BornaBiro/Xmas-Ornament-2025/CrystalBall/PCB/CAD/xmasCrystalBall.kicad_pcb

## KiCad design CrystalBall/PCB/CAD/xmasCrystalBall.kicad_pcb (2025-12-29)

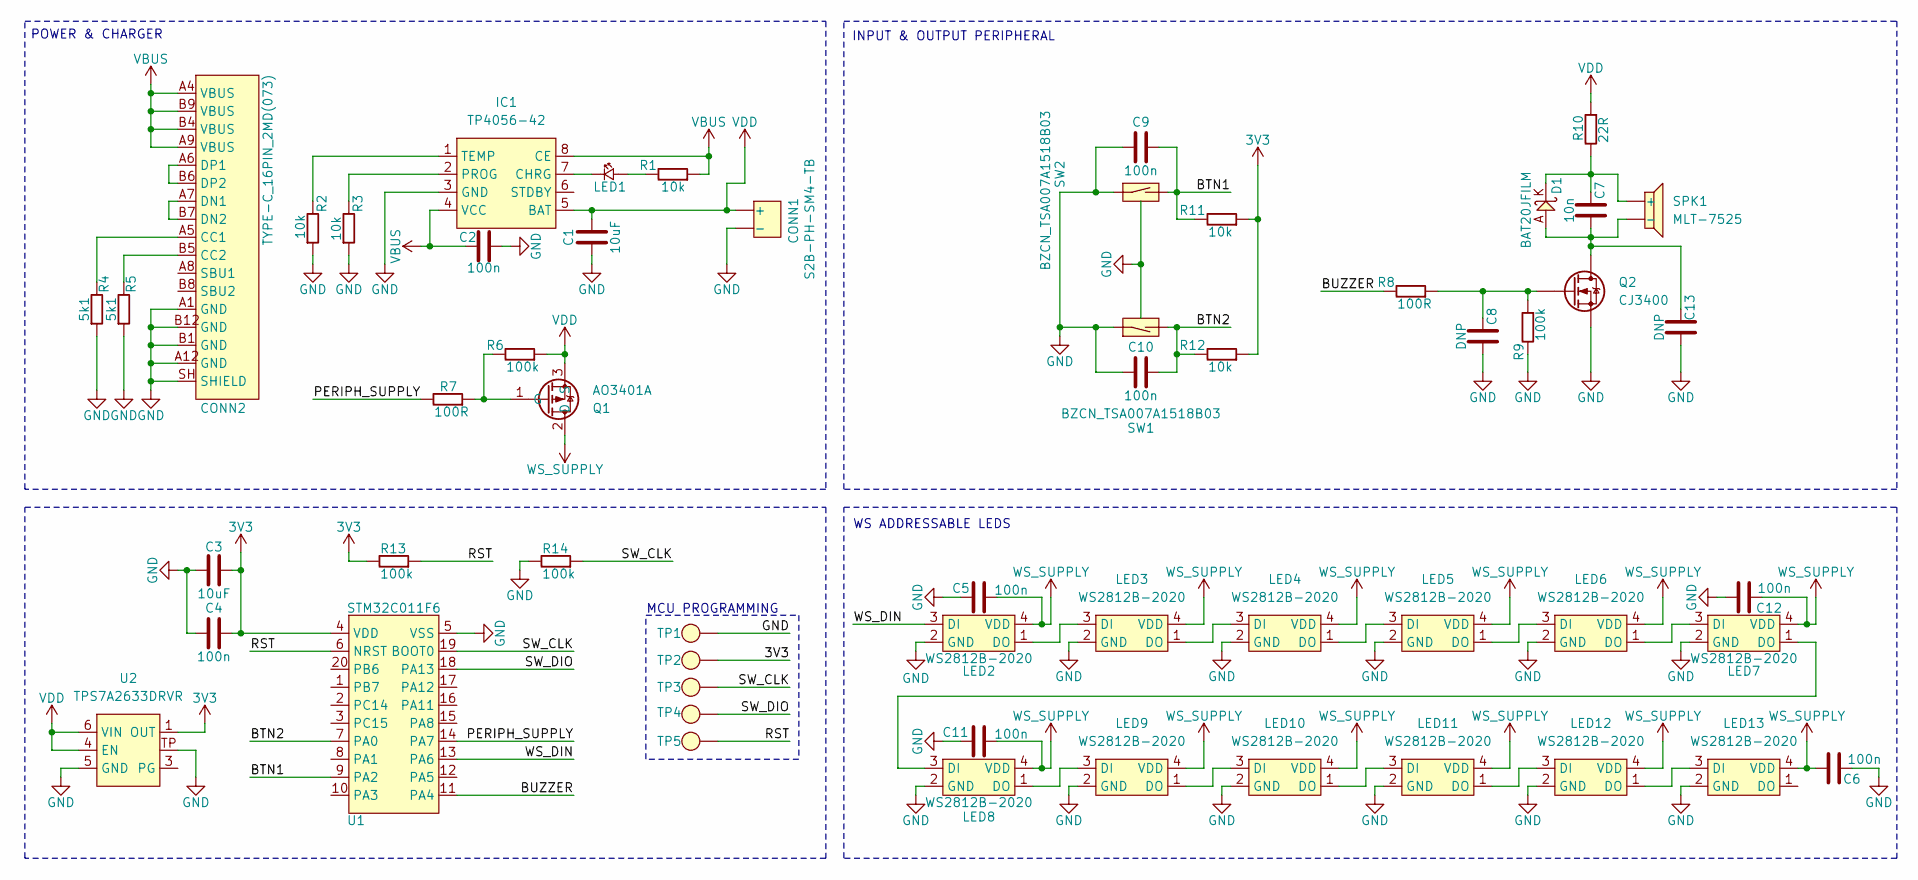
[picture p1: schematic xmasCrystalBall.kicad_sch]

Parts:
C1, C3: 10uF; C1206
C2, C4, C5, C6, C9, C10, C11, C12: 100n; C0603
C7: 10n; C0603
C8, C13: DNP; C0603
CONN1: S2B-PH-SM4-TB; JST_S2B-PH-SM4-TB
CONN2: TYPE-C_16PIN_2MD(073)
D1: BAT20JFILM; SOD323
IC1: TP4056-42; EMSOP
LED1: LED_0603
LED2, LED3, LED4, LED5, LED6, LED7, LED8, LED9, LED10, LED11, LED12, LED13: WS2812B-2020
Q1: AO3401A; SOT-23-3L
Q2: CJ3400; SOT-23-3L
R1, R2, R3, R11, R12: 10k; R0603
R4, R5: 5k1; R0603
R6, R9, R13, R14: 100k; R0603
R7, R8: 100R; R0603
R10: 22R; R0603
SPK1: MLT-7525; MTL-7525
SW1, SW2: BZCN_TSA007A1518B03; TSA007A1518B03
TP1, TP2, TP3, TP4, TP5: TP-1_5mm
U1: STM32C011F6; TSSOP20
U2: TPS7A2633DRVR; WSON-6

Connections:
3V3: C3.2, C4.2, R11.1, R12.1, R13.2, TP2.1 (TP), U1.4 (VDD), U2.1 (OUT)
/BTN1: C9.2, R11.2, SW2.2 (SW2), U1.9 (PA2)
/BTN2: C10.2, R12.2, SW1.2 (SW2), U1.7 (PA0)
/BUZZER: R8.2, U1.11 (PA4)
/PERIPH_SUPPLY: R7.2, U1.14 (PA7)
/RST: R13.1, TP5.1 (TP), U1.6 (NRST)
/SW_CLK: R14.1, TP3.1 (TP), U1.19 (BOOT0)
/SW_DIO: TP4.1 (TP), U1.18 (PA13)
/WS_DIN: LED2.3 (DI), U1.13 (PA6)
GND: C1.1, C2.1, C3.1, C4.1, C5.2, C6.2, C8.1, C9.1, C10.1, C11.2, C12.1, C13.1, CONN1.-, CONN2.A1 (GND), CONN2.A12 (GND), CONN2.B1 (GND), CONN2.B12 (GND), CONN2.SH (SHIELD), IC1.3 (GND), LED2.2 (GND), LED3.2 (GND), LED4.2 (GND), LED5.2 (GND), LED6.2 (GND), LED7.2 (GND), LED8.2 (GND), LED9.2 (GND), LED10.2 (GND), LED11.2 (GND), LED12.2 (GND), LED13.2 (GND), Q2.3 (S), R2.1, R3.1, R4.1, R5.1, R9.2, R14.2, SW1.1 (SW1), SW1.PAD, SW2.1 (SW1), SW2.PAD, TP1.1 (TP), U1.5 (VSS), U2.5 (GND), U2.TP
unnamed: C7.2, D1.K, R10.2, SPK1.+
unnamed: CONN2.A5 (CC1), R4.2
unnamed: CONN2.B5 (CC2), R5.2
unnamed: CONN2.A7 (DN1), CONN2.B7 (DN2)
unnamed: CONN2.A6 (DP1), CONN2.B6 (DP2)
unnamed: IC1.7 (CHRG), LED1.2 (K)
unnamed: IC1.2 (PROG), R3.2
unnamed: IC1.1 (TEMP), R2.2
unnamed: LED1.1 (A), R1.2
unnamed: LED2.1 (DO), LED3.3 (DI)
unnamed: LED3.1 (DO), LED4.3 (DI)
unnamed: LED4.1 (DO), LED5.3 (DI)
unnamed: LED5.1 (DO), LED6.3 (DI)
unnamed: LED6.1 (DO), LED7.3 (DI)
unnamed: LED7.1 (DO), LED8.3 (DI)
unnamed: LED8.1 (DO), LED9.3 (DI)
unnamed: LED9.1 (DO), LED10.3 (DI)
unnamed: LED10.1 (DO), LED11.3 (DI)
unnamed: LED11.1 (DO), LED12.3 (DI)
unnamed: LED12.1 (DO), LED13.3 (DI)
unnamed: Q1.1 (G), R6.2, R7.1
unnamed: C7.1, C13.2, D1.A, Q2.2 (D), SPK1.-
unnamed: C8.2, Q2.1 (G), R8.1, R9.1
VBUS: C2.2, CONN2.A4 (VBUS), CONN2.A9 (VBUS), CONN2.B4 (VBUS), CONN2.B9 (VBUS), IC1.4 (VCC), IC1.8 (CE), R1.1
VDD: C1.2, CONN1.+, IC1.5 (BAT), Q1.3 (S), R6.1, R10.1, U2.4 (EN), U2.6 (VIN)
WS_SUPPLY: C5.1, C6.1, C11.1, C12.2, LED2.4 (VDD), LED3.4 (VDD), LED4.4 (VDD), LED5.4 (VDD), LED6.4 (VDD), LED7.4 (VDD), LED8.4 (VDD), LED9.4 (VDD), LED10.4 (VDD), LED11.4 (VDD), LED12.4 (VDD), LED13.4 (VDD), Q1.2 (D)

Notes on the sheet:
INPUT & OUTPUT PERIPHERAL
POWER & CHARGER
WS ADDRESSABLE LEDS
MCU PROGRAMMING

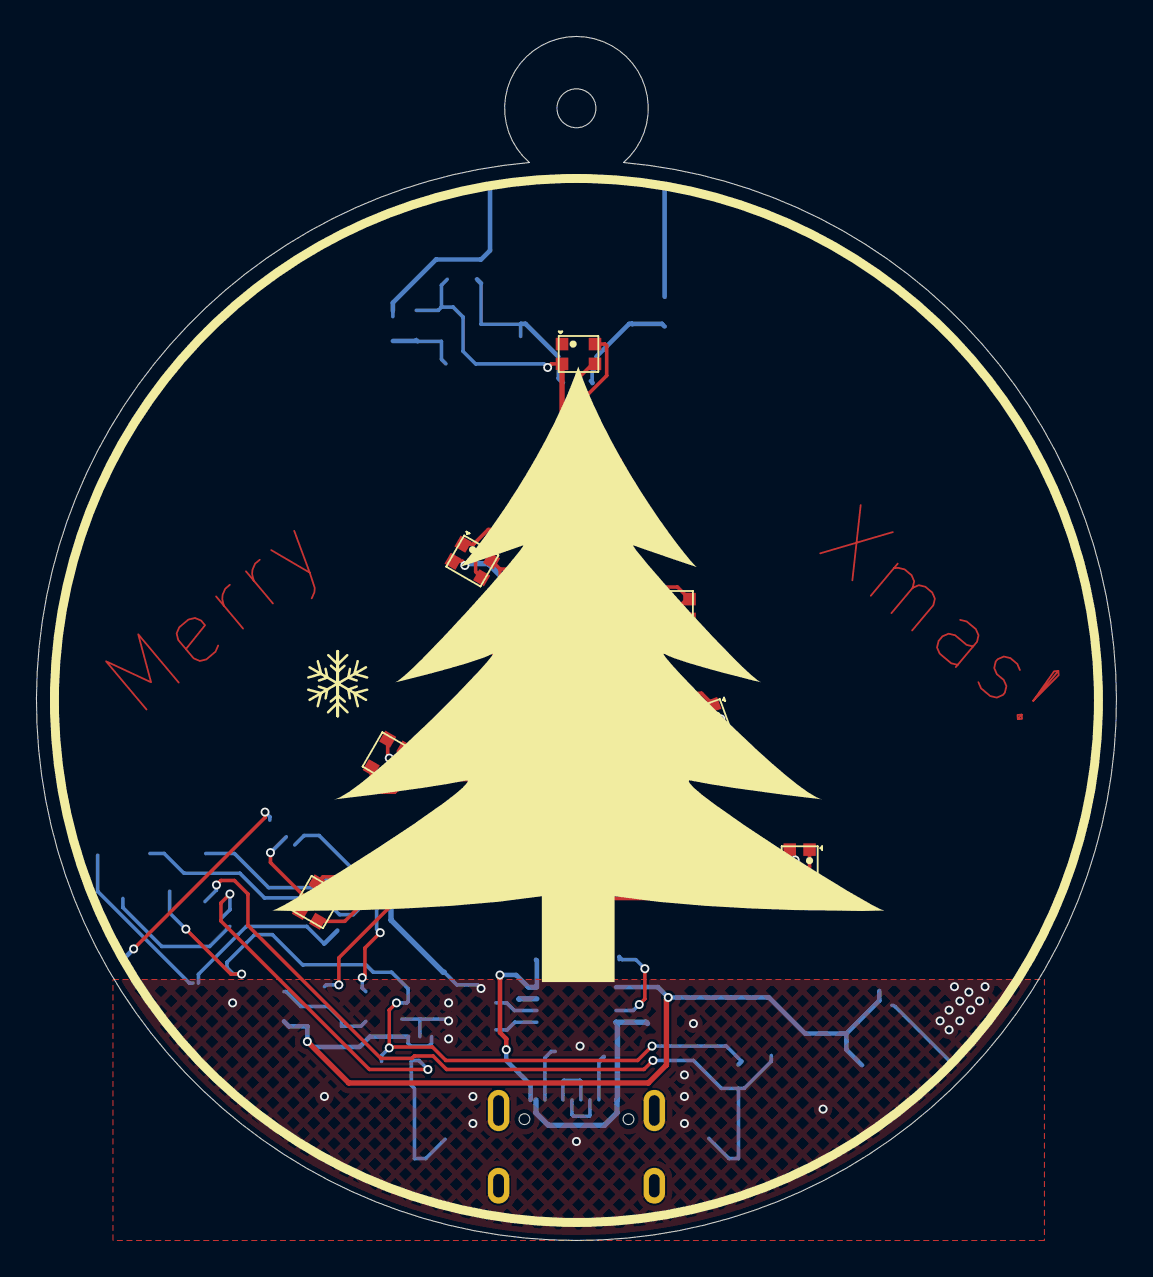
[picture p2: board xmasCrystalBall.kicad_pcb from above]

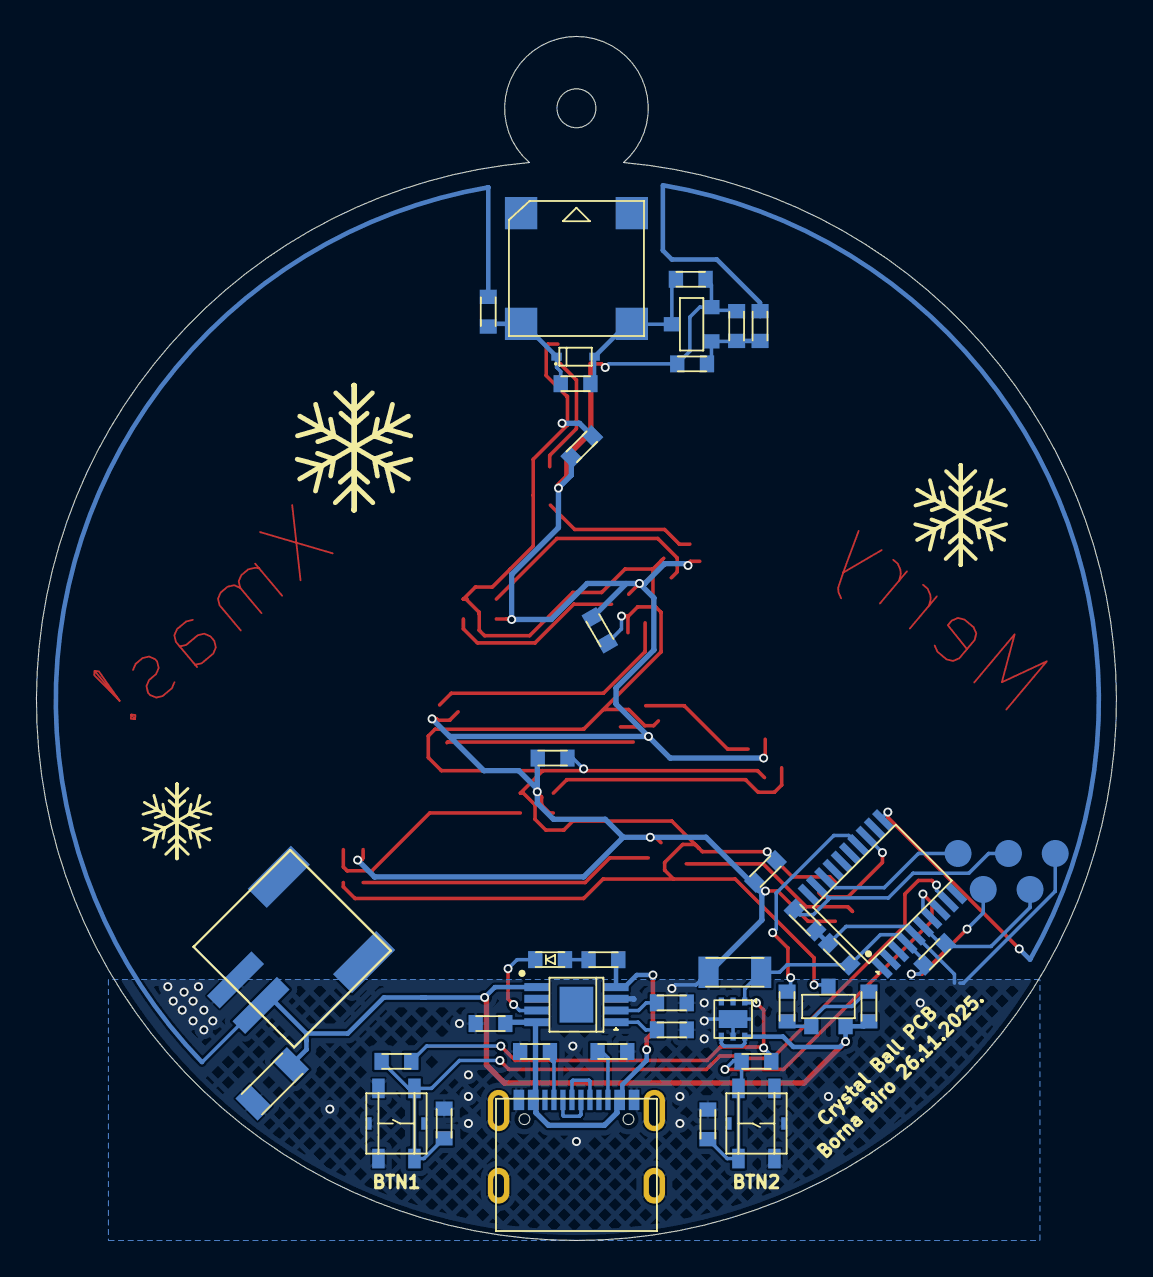
[picture p3: board xmasCrystalBall.kicad_pcb from below]

Board: 2 copper layers, 60.0 x 66.9 mm, 56 parts (44 on the bottom side), 36 nets.
