BornaBiro/Xmas-Ornament-2025/CrystalBall/Firmware/xmasOrnament2025/Core/Src/main.cpp

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
/* Includes ------------------------------------------------------------------*/
#include "main.h"

/* USER CODE BEGIN Includes */
#include <stdint.h>
#include <stdbool.h>
#include "WS2812.h"
#include "Buzzer.h"
#include "oneButton.h"
#include "melodioes.h"
#include "melodyController.h"
/* USER CODE END Includes */

/* USER CODE BEGIN PD */
#define DEVICE_AUTO_OFF_TIME_MS     (5ULL * 60ULL * 1000ULL)
/* USER CODE END PD */


TIM_HandleTypeDef htim3;
TIM_HandleTypeDef htim14;
DMA_HandleTypeDef hdma_tim3_ch1;

/* USER CODE BEGIN PV */
typedef struct
{
    uint16_t hue;
    uint8_t sat;
    uint8_t val;
}hsvColorTypedef;

hsvColorTypedef xmasColors[] =
{
        {       // Red color
                .hue = (uint16_t)(0.0 / 360.0 * 65535),
                .sat = (uint8_t)(94.0 / 100.0 * 255.0),
                .val = 13
        },
        {       // Green color
                .hue = (uint16_t)(105.0 / 360.0 * 65535),
                .sat = (uint8_t)(82.0 / 100.0 * 255.0),
                .val = 5
        },
        {       // Yellow color
                .hue = (uint16_t)(35.0 / 360.0 * 65535),
                .sat = (uint8_t)(98.0 / 100.0 * 255.0),
                .val = 15
        },
        {       // Blue color
                .hue = (uint16_t)(202.0 / 360.0 * 65535),
                .sat = (uint8_t)(94.0 / 100.0 * 255.0),
                .val = 4
        },
        {       // Pink color
                .hue = (uint16_t)(359.0 / 360.0 * 65535),
                .sat = (uint8_t)(80.0 / 100.0 * 255.0),
                .val = 13
        },
        {       // White color
                .hue = (uint16_t)(200.0 / 360.0 * 65535),
                .sat = (uint8_t)(20.0 / 100.0 * 255.0),
                .val = 5
        },
        {       // Warm white color
                .hue = (uint16_t)(30.0 / 360.0 * 65535),
                .sat = (uint8_t)(81.0 / 100.0 * 255.0),
                .val = 10
        }
};

uint32_t onTime = 0;
int ledColorShift = 0;
uint8_t _ledMode = 0;
/* USER CODE END PV */

void SystemClock_Config(void);
static void MX_GPIO_Init(void);
static void MX_DMA_Init(void);
static void MX_TIM3_Init(void);
static void MX_TIM14_Init(void);
/* USER CODE BEGIN PFP */
OneButton btn1;
OneButton btn2;

// Create an object for the melody controller.
MelodyController melody;

void deviceShutDown();
/* USER CODE END PFP */

/**
  * @brief  The application entry point.
  * @retval int
  */
int main(void)
{

  /* MCU Configuration--------------------------------------------------------*/

  /* Reset of all peripherals, Initializes the Flash interface and the Systick. */
  HAL_Init();

  /* Configure the system clock */
  SystemClock_Config();

  /* Initialize all configured peripherals */
  MX_GPIO_Init();
  MX_DMA_Init();
  MX_TIM3_Init();
  MX_TIM14_Init();
  /* USER CODE BEGIN 2 */

  // Enable the supply for the buzzer and LEDs.
  HAL_GPIO_WritePin(PERIPH_EN_GPIO_Port, PERIPH_EN_Pin, GPIO_PIN_RESET);
  // Wait a little bit.
  HAL_Delay(100ULL);

  // Initialize the buzzer library.
  buzzer_begin(&htim14);

  // Initialize the WS LED library.
  if (!ws2812_begin(&htim3, &hdma_tim3_ch1, TIM_CHANNEL_1, 12, 2, 9, 6, 3))
  {
      while(1);
  }

  // Init library for the melody contoller.
  melody.begin((uint16_t**)currentMelodyNotes, (uint16_t**)currentMelodyDurations, (uint8_t*)melodyElements, sizeof(melodyElements) / sizeof(melodyElements[0]));
  melody.play();
  /* USER CODE END 2 */

  /* Infinite loop */
  /* USER CODE BEGIN WHILE */
  while (1)
  {
      // Check the button(s).
      btn1.loop();
      btn2.loop();

      int update = melody.update();

      if (btn1.isPressed())
              melody.next();

      if (btn2.isPressed())
      {
          _ledMode = (_ledMode + 1) % 3;
      }

      if (btn2.isLongPressed())
      {
          melody.setMute(!melody.getMute());
      }

      if (btn1.isLongPressed())
      {
          deviceShutDown();
      }

      // Go thought the colors every one second.
      if (update)
      {
          if (update == 2)
              _ledMode = (_ledMode + 1) % 3;

          if (_ledMode == 0)
          {
              uint8_t colors[] = {0, 2};
              // Set the new colors on LEDs.
              for (int i = 0; i < 12; i++)
              {
                  uint8_t _currentColorIndex = colors[(i + ledColorShift / 2) % 2] + (ledColorShift & 1);
                  ws2812_setPixelColor(i, ws2812_hsv(xmasColors[_currentColorIndex].hue, xmasColors[_currentColorIndex].sat, xmasColors[_currentColorIndex].val));
              }
              ledColorShift++;

              // Push the new colors to the LEDs.
              ws2812_show();
          }
          else if (_ledMode == 1)
          {
              // Set the new colors on LEDs.
              for (int i = 0; i < 12; i++)
              {
                  ws2812_setPixelColor(i, ws2812_hsv(xmasColors[(ledColorShift + i) % 5].hue, xmasColors[(ledColorShift + i) % 5].sat, xmasColors[(ledColorShift + i) % 5].val));
              }
              ledColorShift++;

              // Push the new colors to the LEDs.
              ws2812_show();
          }
          else if (_ledMode == 2)
          {
              // Set the new colors on LEDs.
              for (int i = 0; i < 12; i++)
              {
                  ws2812_setPixelColor(i, ws2812_hsv(xmasColors[ledColorShift % 5].hue, xmasColors[ledColorShift % 5].sat, xmasColors[ledColorShift % 5].val));
              }
              ledColorShift++;

              // Push the new colors to the LEDs.
              ws2812_show();
          }
      }

      // If 10 minutes passed, shut down the ornament and prepare everything for the power up on the button.
      if ((uint32_t)(HAL_GetTick() - onTime) > DEVICE_AUTO_OFF_TIME_MS)
      {
          // Update the timer.
          onTime = HAL_GetTick();

          deviceShutDown();
      }
    /* USER CODE END WHILE */

    /* USER CODE BEGIN 3 */
  }
  /* USER CODE END 3 */
}

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
/* USER CODE BEGIN 4 */
void HAL_GPIO_EXTI_Rising_Callback(uint16_t GPIO_Pin)
{
    //risingInt = true;
    if (GPIO_Pin == GPIO_PIN_2) btn1.updateState(HAL_GetTick(), 1);
    if (GPIO_Pin == GPIO_PIN_0) btn2.updateState(HAL_GetTick(), 1);
}

void HAL_GPIO_EXTI_Falling_Callback(uint16_t GPIO_Pin)
{
    if (GPIO_Pin == GPIO_PIN_2) btn1.updateState(HAL_GetTick(), 0);
    if (GPIO_Pin == GPIO_PIN_0) btn2.updateState(HAL_GetTick(), 0);
}

void deviceShutDown()
{
    // Turn off all LEDs.
    for (int i = 0; i < 12; i++)
    {
        ws2812_setPixelColor(i, 0);
    }

    // Push the new colors to the LEDs.
    ws2812_show();

    // Disable the supply to the LEDs and buzzer.
    HAL_GPIO_WritePin(PERIPH_EN_GPIO_Port, PERIPH_EN_Pin, GPIO_PIN_SET);

    // Disable the timers for LEDs and buzzer.
    HAL_TIM_PWM_DeInit(&htim14);
    HAL_TIM_PWM_DeInit(&htim3);

    while(HAL_GPIO_ReadPin(GPIOA, GPIO_PIN_2) == GPIO_PIN_RESET);

    // Set the wake up pins.
    //HAL_PWR_DisableWakeUpPin(PWR_WAKEUP_PIN1);
    HAL_PWR_DisableWakeUpPin(PWR_WAKEUP_PIN4);
    //HAL_PWR_EnableWakeUpPin(PWR_WAKEUP_PIN1_LOW);
    HAL_PWR_EnableWakeUpPin(PWR_WAKEUP_PIN4_LOW);
    __HAL_PWR_CLEAR_FLAG(PWR_FLAG_WUF);

    // Disable the tick
    HAL_SuspendTick();

    // Shut-down whole device.
    HAL_PWREx_EnterSHUTDOWNMode();
}
/* USER CODE END 4 */
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
