BornaBiro/Xmas-Ornament-2025/CrystalBall/Firmware/xmasOrnament2025/xmasOrnament2025.ioc

Mcu.UserName=STM32C011F6Px
PA0.GPIO_Label=USER_BTN2
PA0.Signal=GPXTI0
PA2.GPIO_Label=USER_BTN1
PA2.Signal=GPXTI2
PA4.Signal=S_TIM14_CH1
PA6.Signal=S_TIM3_CH1
PA7.GPIO_Label=PERIPH_EN
PA7.Signal=GPIO_Output
