BornaBiro/Xmas-Ornament-2025/CrystalBall/Firmware/xmasOrnament2025/Core/Inc/main.h

#define USER_BTN2_Pin GPIO_PIN_0
#define USER_BTN2_GPIO_Port GPIOA
#define USER_BTN2_EXTI_IRQn EXTI0_1_IRQn
#define USER_BTN1_Pin GPIO_PIN_2
#define USER_BTN1_GPIO_Port GPIOA
#define USER_BTN1_EXTI_IRQn EXTI2_3_IRQn
#define PERIPH_EN_Pin GPIO_PIN_7
#define PERIPH_EN_GPIO_Port GPIOA
