BornaBiro/Xmas-Ornament-2025/(notices)

Notices in the files:
CrystalBall/Firmware/xmasOrnament2025/Core/Inc/main.h:
Copyright (c) 2025 STMicroelectronics.
All rights reserved.
This software is licensed under terms that can be found in the LICENSE file
